MrBlinky/Arduboy-Progger/images/breadboard-dev-setup.jpg

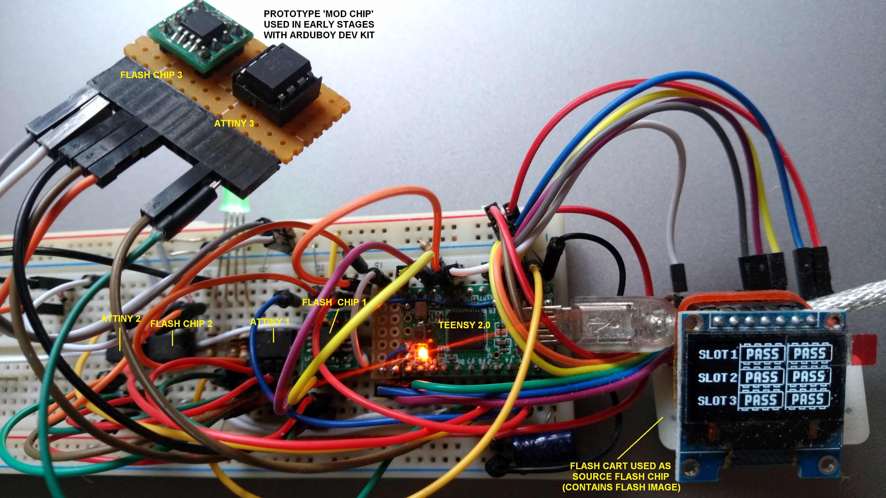
images/breadboard-dev-setup.jpg
