MrBlinky/Arduboy-Progger/schematic/arduboy-progger.png

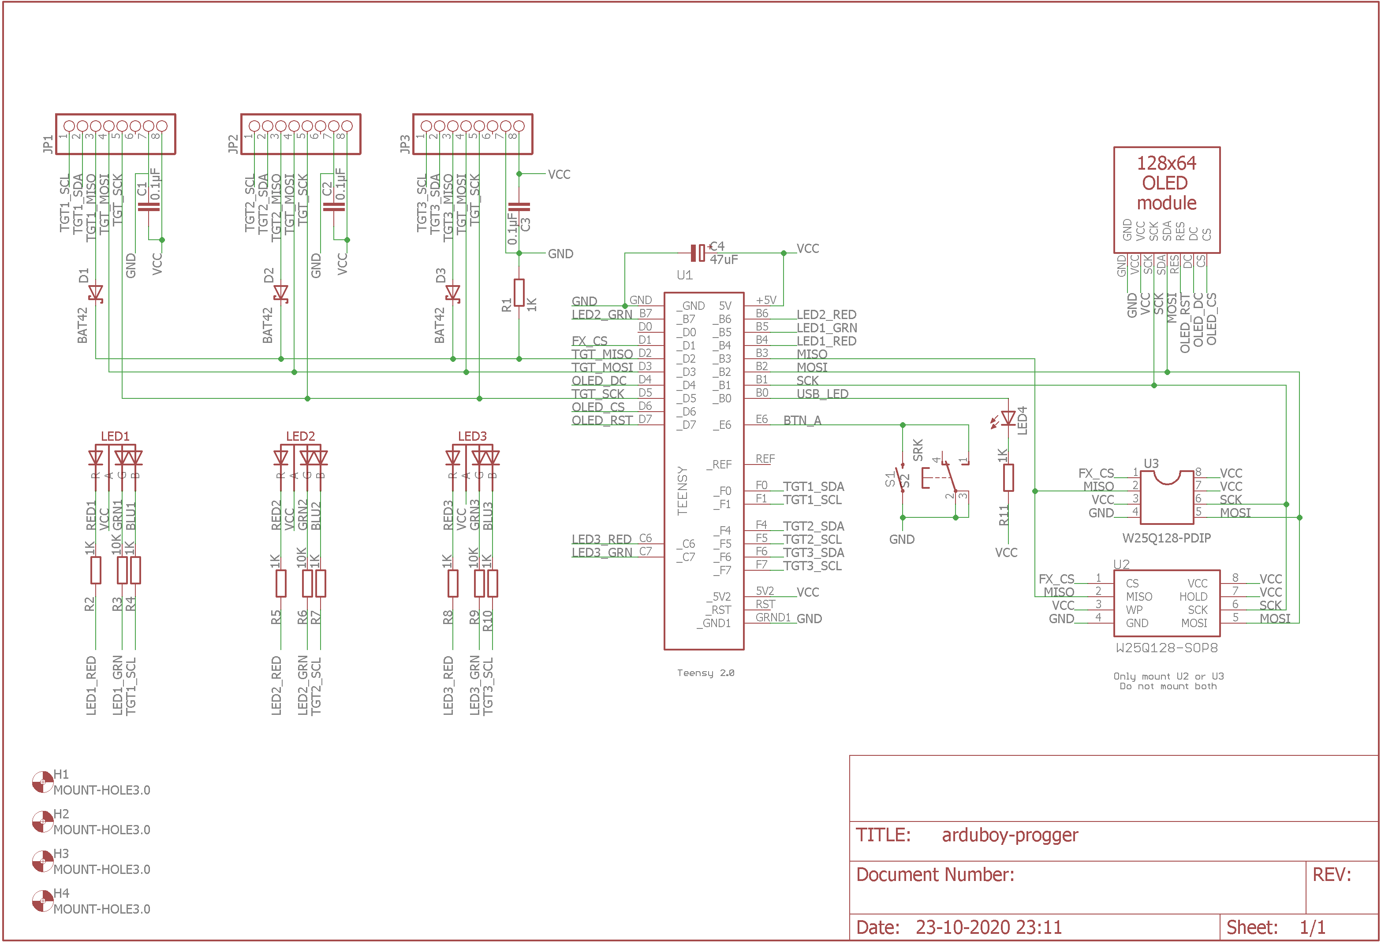
schematic/arduboy-progger.png
