MrBlinky/Arduboy-Progger/schematic/arduboy-progger.sch

## EAGLE design schematic/arduboy-progger.sch (2020-10-23)

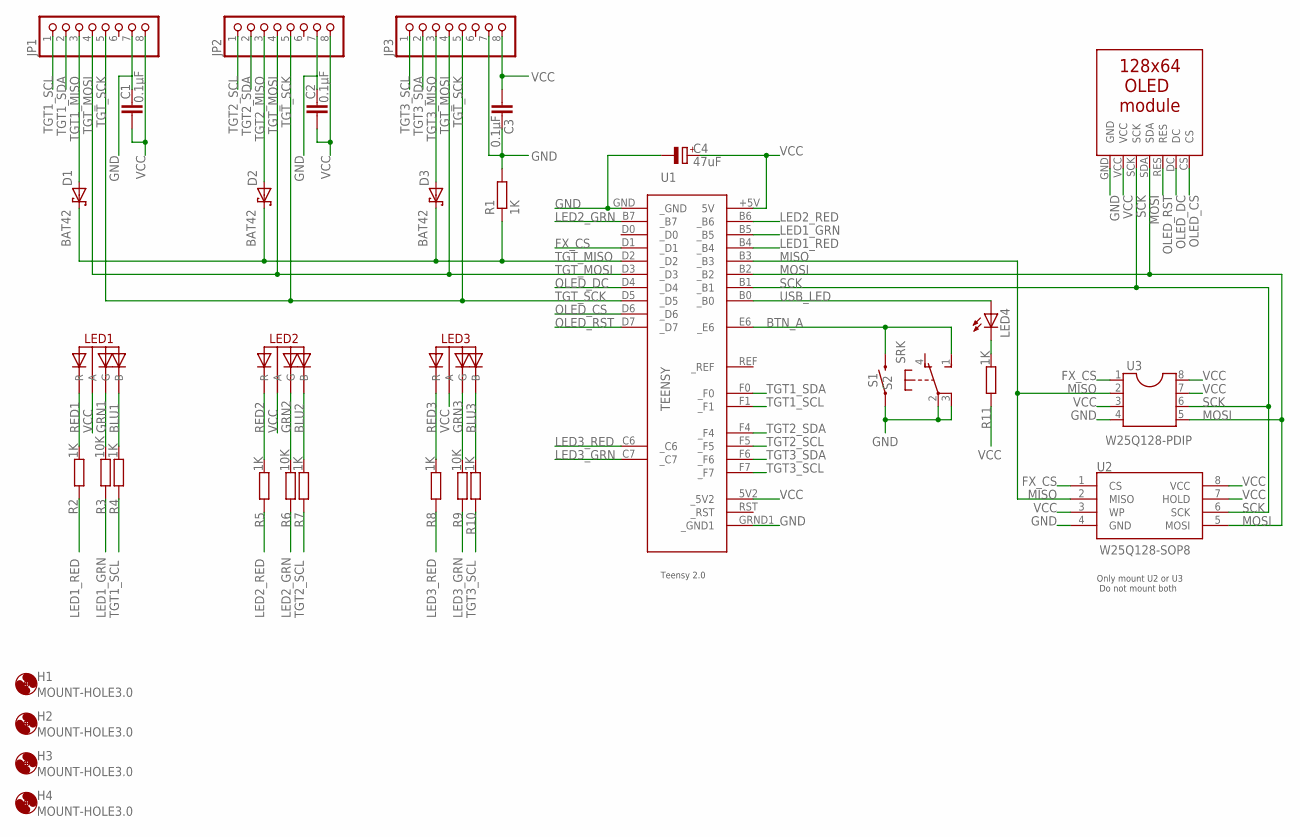
[picture p3: schematic arduboy-progger.sch]

Parts:
C1, C2, C3: 0.1µF; C025-025X050
C4: 47uF; E2,5-6
D1, D2, D3: BAT42; DO35-10
H1, H2, H3, H4: MOUNT-HOLE3.0; 3,0
JP1, JP2, JP3: PINHD-1X8; 1X08
LED1, LED2, LED3: 5MMRGBLED-CA; LED5MMRGB
LED4: LED5MM
OLED1: OLED
R1, R2, R4, R5, R7, R8, R10, R11: 1K; 0207/10
R3, R6, R9: 10K; 0207/10
S1: MOMENTARY-SWITCH-SPST-PTH-6.0MM; TACTILE_SWITCH_PTH_6.0MM
S2: SRK
U1: TEENSY
U2: W25Q128-SOP8; SO08-EIAJ
U3: W25Q128-PDIP; SOCKET-08

Connections:
BLU1: LED1.B$1 (B), R4.2
BLU2: LED2.B$1 (B), R7.2
BLU3: LED3.B$1 (B), R10.2
BTN_A: S1.3 (2), S2.1 (S), U1.E6 (_E6)
FX_CS: U1.D1 (_D1), U2.1 (CS), U3.1
GND: C1.1, C2.1, C3.1, C4.-, JP1.7, JP2.7, JP3.7, OLED1.GND, R1.2, S1.1, S2.2, S2.3, U1.GND (_GND), U1.GRND1 (_GND1), U2.4 (GND), U3.4
GRN1: LED1.G$1 (G), R3.2
GRN2: LED2.G$1 (G), R6.2
GRN3: LED3.G$1 (G), R9.2
LED1_GRN: R3.1, U1.B5 (_B5)
LED1_RED: R2.1, U1.B4 (_B4)
LED2_GRN: R6.1, U1.B7 (_B7)
LED2_RED: R5.1, U1.B6 (_B6)
LED3_GRN: R9.1, U1.C7 (_C7)
LED3_RED: R8.1, U1.C6 (_C6)
MISO: U1.B3 (_B3), U2.2 (MISO), U3.2
MOSI: OLED1.SDA, U1.B2 (_B2), U2.5 (MOSI), U3.5
unnamed: LED4.K (C), R11.2
OLED_CS: OLED1.CS, U1.D6 (_D6)
OLED_DC: OLED1.DC, U1.D4 (_D4)
OLED_RST: OLED1.RES, U1.D7 (_D7)
RED1: LED1.R$1 (R), R2.2
RED2: LED2.R$1 (R), R5.2
RED3: LED3.R$1 (R), R8.2
SCK: OLED1.SCK, U1.B1 (_B1), U2.6 (SCK), U3.6
TGT1_MISO: D1.A, JP1.3
TGT1_SCL: JP1.1, R4.1, U1.F1 (_F1)
TGT1_SDA: JP1.2, U1.F0 (_F0)
TGT2_MISO: D2.A, JP2.3
TGT2_SCL: JP2.1, R7.1, U1.F5 (_F5)
TGT2_SDA: JP2.2, U1.F4 (_F4)
TGT3_MISO: D3.A, JP3.3
TGT3_SCL: JP3.1, R10.1, U1.F7 (_F7)
TGT3_SDA: JP3.2, U1.F6 (_F6)
TGT_MISO: D1.C, D2.C, D3.C, R1.1, U1.D2 (_D2)
TGT_MOSI: JP1.4, JP2.4, JP3.4, U1.D3 (_D3)
TGT_SCK: JP1.5, JP2.5, JP3.5, U1.D5 (_D5)
USB_LED: LED4.A, U1.B0 (_B0)
VCC: C1.2, C2.2, C3.2, C4.+, JP1.8, JP2.8, JP3.8, LED1.C$1 (A), LED2.C$1 (A), LED3.C$1 (A), OLED1.VCC, R11.1, U1.5V2 (_5V2), U1.+5V (5V), U2.3 (WP), U2.7 (HOLD), U2.8 (VCC), U3.3, U3.7, U3.8

Notes on the sheet:
Only mount U2 or U3 Do not mount both
