MrBlinky/Arduboy-Progger/arduboy-progger/fxStateBitmap.h

#pragma once
constexpr uint8_t fxStateBitmapWidth = 44;
constexpr uint8_t fxStateBitmapHeight = 24;

const uint8_t PROGMEM fxStateBitmap[] =
{
  fxStateBitmapWidth, fxStateBitmapHeight,
  //Frame 0
  0x00, 0x54, 0x00, 0x02, 0x00, 0x02, 0x00, 0x02, 0x00, 0x02, 0x00, 0x02, 0x20, 0x22, 0x60, 0x42, 0xC0, 0x82, 0x80, 0x02, 0x00, 0x02, 0x00, 0x02, 0x00, 0x02, 0x80, 0x82, 0xC0, 0x42, 0x60, 0x22, 0x20, 0x02, 0x00, 0x02, 0x00, 0x02, 0x00, 0x02, 0x00, 0x02, 0x00, 0x54, 
  0x00, 0x55, 0x00, 0x00, 0x00, 0x00, 0x00, 0x00, 0x00, 0x00, 0x00, 0x00, 0x40, 0x40, 0x60, 0x20, 0x30, 0x10, 0x19, 0x09, 0x0F, 0x06, 0x06, 0x06, 0x0F, 0x09, 0x19, 0x10, 0x30, 0x20, 0x60, 0x40, 0x40, 0x00, 0x00, 0x00, 0x00, 0x00, 0x00, 0x00, 0x00, 0x00, 0x00, 0x55, 
  0x00, 0x01, 0x00, 0x02, 0x00, 0x02, 0x00, 0x02, 0x00, 0x02, 0x00, 0x02, 0x00, 0x02, 0x00, 0x02, 0x00, 0x02, 0x00, 0x02, 0x00, 0x02, 0x00, 0x02, 0x00, 0x02, 0x00, 0x02, 0x00, 0x02, 0x00, 0x02, 0x00, 0x02, 0x00, 0x02, 0x00, 0x02, 0x00, 0x02, 0x00, 0x02, 0x00, 0x01, 

  //Frame 1
  0xF8, 0x04, 0x04, 0x04, 0x07, 0x05, 0x05, 0x05, 0x05, 0x07, 0x84, 0xC4, 0xC4, 0xC4, 0xE7, 0xE5, 0xE5, 0x75, 0x75, 0x77, 0x34, 0xB4, 0xB4, 0x34, 0x07, 0x05, 0x05, 0x05, 0x85, 0xC7, 0xE4, 0xE4, 0xF4, 0x74, 0x27, 0x05, 0x05, 0x05, 0x05, 0x07, 0x04, 0x04, 0x04, 0xF8, 
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
  0xFF, 0x02, 0x02, 0x02, 0x0E, 0x0A, 0x0A, 0x0A, 0x0A, 0x0E, 0x02, 0x02, 0x02, 0x02, 0x0E, 0x0A, 0x0A, 0x0A, 0x0A, 0x0E, 0x02, 0x02, 0x02, 0x02, 0x0E, 0x0A, 0x0A, 0x0A, 0x0A, 0x0E, 0x02, 0x02, 0x02, 0x02, 0x0E, 0x0A, 0x0A, 0x0A, 0x0A, 0x0E, 0x02, 0x02, 0x02, 0x01
};
