MrBlinky/Arduboy-Progger/arduboy-progger/startBitmap.h

#pragma once
constexpr uint8_t startBitmapWidth = 128;
constexpr uint8_t startBitmapHeight = 64;

const uint8_t PROGMEM startBitmap[] =
{
  startBitmapWidth, startBitmapHeight,
  //Frame 0
  0x00, 0x00, 0x00, 0xF8, 0x04, 0x04, 0x04, 0x07, 0x05, 0x05, 0x05, 0x05, 0x07, 0x84, 0xC4, 0xC4, 0xC4, 0xE7, 0xE5, 0xE5, 0x75, 0x75, 0x77, 0x34, 0xB4, 0xB4, 0x34, 0x07, 0x05, 0x05, 0x05, 0x85, 0xC7, 0xE4, 0xE4, 0xF4, 0x74, 0x27, 0x05, 0x05, 0x05, 0x05, 0x07, 0x04, 0x04, 0x04, 0xF8, 0x00, 0x00, 0x00, 0xE0, 0xE0, 0x60, 0x60, 0xE0, 0xC0, 0x00, 0x00, 0xE0, 0xE0, 0x60, 0x60, 0xE0, 0xC0, 0x00, 0x00, 0xC0, 0xE0, 0x60, 0x60, 0xE0, 0xC0, 0x00, 0x00, 0xC0, 0xE0, 0x60, 0x60, 0xE0, 0xC0, 0x00, 0x00, 0xC0, 0xE0, 0x60, 0x60, 0xE0, 0xC0, 0x00, 0x00, 0xE0, 0xE0, 0x60, 0x60, 0x60, 0x60, 0x00, 0x00, 0xE0, 0xE0, 0x60, 0x60, 0xE0, 0xC0, 0x00, 0x00, 0x00, 0x00, 0x00, 0x00, 0x00, 0x00, 0x00, 0x00, 0x00, 0x00, 0x00, 0x00, 0x00, 0x00, 0x00, 0x00, 0x00, 0x00, 0x00, 0x00, 0x00, 0x00, 
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
};
