MrBlinky/Arduboy-Progger/arduboy-progger/eraseBitmap.h

#pragma once
constexpr uint8_t eraseBitmapWidth = 110;
constexpr uint8_t eraseBitmapHeight = 16;

const uint8_t PROGMEM eraseBitmap[] =
{
  eraseBitmapWidth, eraseBitmapHeight,
  //Frame 0
  0xFF, 0xFF, 0x33, 0x33, 0x33, 0x03, 0x00, 0x00, 0xFF, 0xFF, 0x63, 0x63, 0xFF, 0xBE, 0x00, 0x00, 0xFE, 0xFF, 0x63, 0x63, 0xFF, 0xFE, 0x00, 0x00, 0x9E, 0xBF, 0x33, 0x33, 0xF7, 0xE6, 0x00, 0x00, 0x03, 0xFF, 0xFF, 0x03, 0x00, 0x00, 0xFF, 0xFF, 0x1E, 0x78, 0xE0, 0xFF, 0xFF, 0x00, 0x00, 0xFE, 0xFF, 0x03, 0x23, 0xE7, 0xE6, 0x00, 0x00, 0x00, 0x00, 0x00, 0x00, 0x00, 0xFF, 0xFF, 0x33, 0x33, 0x33, 0x03, 0x00, 0x00, 0xFF, 0xFF, 0x00, 0x00, 0x00, 0x00, 0x00, 0x00, 0xFE, 0xFF, 0x63, 0x63, 0xFF, 0xFE, 0x00, 0x00, 0x9E, 0xBF, 0x33, 0x33, 0xF7, 0xE6, 0x00, 0x00, 0xFF, 0xFF, 0x30, 0x30, 0xFF, 0xFF, 0x00, 0x00, 0x00, 0x00, 0x00, 0x00, 0x00, 0x00, 0x00, 0x00, 0x00, 0x00, 
  0x03, 0x03, 0x03, 0x03, 0x03, 0x03, 0x00, 0x00, 0x03, 0x03, 0x00, 0x00, 0x03, 0x03, 0x00, 0x00, 0x03, 0x03, 0x00, 0x00, 0x03, 0x03, 0x00, 0x00, 0x01, 0x03, 0x03, 0x03, 0x03, 0x01, 0x00, 0x00, 0x03, 0x03, 0x03, 0x03, 0x00, 0x00, 0x03, 0x03, 0x00, 0x00, 0x01, 0x03, 0x03, 0x00, 0x00, 0x01, 0x03, 0x03, 0x03, 0x03, 0x01, 0x00, 0x00, 0x00, 0x00, 0x00, 0x00, 0x00, 0x03, 0x03, 0x00, 0x00, 0x00, 0x00, 0x00, 0x00, 0x03, 0x03, 0x03, 0x03, 0x03, 0x03, 0x00, 0x00, 0x03, 0x03, 0x00, 0x00, 0x03, 0x03, 0x00, 0x00, 0x01, 0x03, 0x03, 0x03, 0x03, 0x01, 0x00, 0x00, 0x03, 0x03, 0x00, 0x00, 0x03, 0x03, 0x00, 0x00, 0x03, 0x03, 0x00, 0x00, 0x03, 0x03, 0x00, 0x00, 0x03, 0x03
};
