MrBlinky/Arduboy-Progger/arduboy-progger/numbersBitmap.h

#pragma once
constexpr uint8_t numbersBitmapWidth = 6;
constexpr uint8_t numbersBitmapHeight = 16;

const uint8_t PROGMEM numbersBitmap[] =
{
  numbersBitmapWidth, numbersBitmapHeight,
  //Frame 0
  0xFE, 0xFF, 0x03, 0x03, 0xFF, 0xFE, 
  0x01, 0x03, 0x03, 0x03, 0x03, 0x01, 

  //Frame 1
  0x00, 0x06, 0xFF, 0xFF, 0x00, 0x00, 
  0x03, 0x03, 0x03, 0x03, 0x03, 0x03, 

  //Frame 2
  0x86, 0xC7, 0x63, 0x33, 0x1F, 0x0E, 
  0x03, 0x03, 0x03, 0x03, 0x03, 0x03, 

  //Frame 3
  0x86, 0x87, 0x33, 0x33, 0xFF, 0xCE, 
  0x01, 0x03, 0x03, 0x03, 0x03, 0x01, 

  //Frame 4
  0x3E, 0x3E, 0x30, 0x30, 0xFF, 0xFF, 
  0x00, 0x00, 0x00, 0x00, 0x03, 0x03, 

  //Frame 5
  0x3F, 0x3F, 0x33, 0x33, 0xF3, 0xE3, 
  0x03, 0x03, 0x03, 0x03, 0x03, 0x01, 

  //Frame 6
  0xFE, 0xFF, 0x33, 0x33, 0xF7, 0xE6, 
  0x01, 0x03, 0x03, 0x03, 0x03, 0x01, 

  //Frame 7
  0x07, 0x07, 0x83, 0xF3, 0x7F, 0x0F, 
  0x00, 0x00, 0x03, 0x03, 0x00, 0x00, 

  //Frame 8
  0xCE, 0xFF, 0x33, 0x33, 0xFF, 0xCE, 
  0x01, 0x03, 0x03, 0x03, 0x03, 0x01, 

  //Frame 9
  0x9E, 0xBF, 0x33, 0x33, 0xFF, 0xFE, 
  0x01, 0x03, 0x03, 0x03, 0x03, 0x01, 

  //Frame 10
  0xFE, 0xFF, 0x63, 0x63, 0xFF, 0xFE, 
  0x03, 0x03, 0x00, 0x00, 0x03, 0x03, 

  //Frame 11
  0xFF, 0xFF, 0x33, 0x33, 0xFF, 0xCE, 
  0x03, 0x03, 0x03, 0x03, 0x03, 0x01, 

  //Frame 12
  0xFE, 0xFF, 0x03, 0x03, 0x87, 0x86, 
  0x01, 0x03, 0x03, 0x03, 0x03, 0x01, 

  //Frame 13
  0xFF, 0xFF, 0x03, 0x03, 0xFF, 0xFE, 
  0x03, 0x03, 0x03, 0x03, 0x03, 0x01, 

  //Frame 14
  0xFF, 0xFF, 0x33, 0x33, 0x33, 0x03, 
  0x03, 0x03, 0x03, 0x03, 0x03, 0x03, 

  //Frame 15
  0xFF, 0xFF, 0x33, 0x33, 0x33, 0x03, 
  0x03, 0x03, 0x00, 0x00, 0x00, 0x00
};
