MrBlinky/Arduboy-Progger/(commit log)

2020-10-23 hardware change, sketch update
    Diodes D1..D3 polarity swapped, R1 becomes pull down.
    This modification will allow simultanious programming of the attinies and flash chips.
    sketch determins size of flash image stored in flash chip on power on.
    experimental simultanious programming of flash chips
    [arduboy-progger.sch]
2020-10-23 fix flash chip programming
    [arduboy-progger.ino]
2020-10-24 add erase feature fix startup bug
    holding down the button for 2 seconds while powering on erases the flash image stored in the onboard flash chip
    [arduboy-progger.ino, eraseBitmap.h]
