MrBlinky/Arduboy-Progger/(notices)

Notices in the files:
parts and their libraries:
teensy: Licensed Under Creative Commons Attribution-ShareAlike 3.0 Unported (CC BY-SA 3.0)
